AlanFord/CurrentSinkOrSwim/README.md

# CurrentSinkOrSwim
Building a current sink for battery testing in Contextual Electronics.

Here's the project so far:

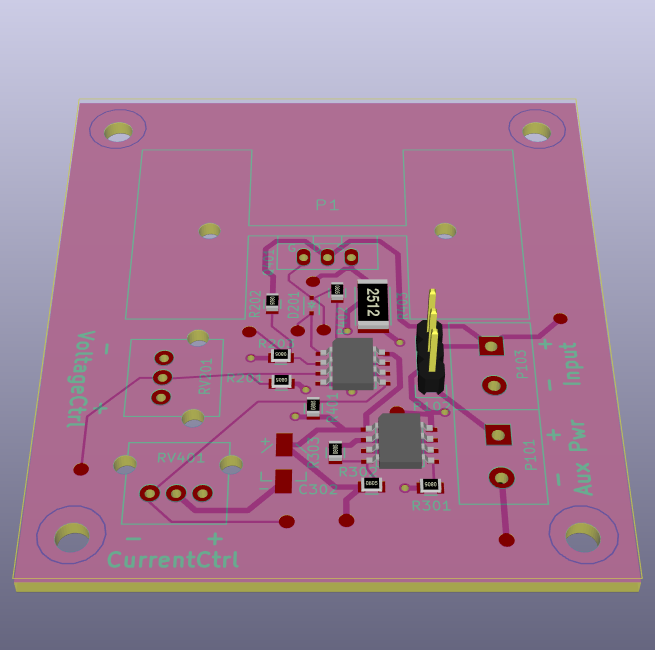
[picture p1: IMAGES/CurrentSinkOrSwim.png]


and

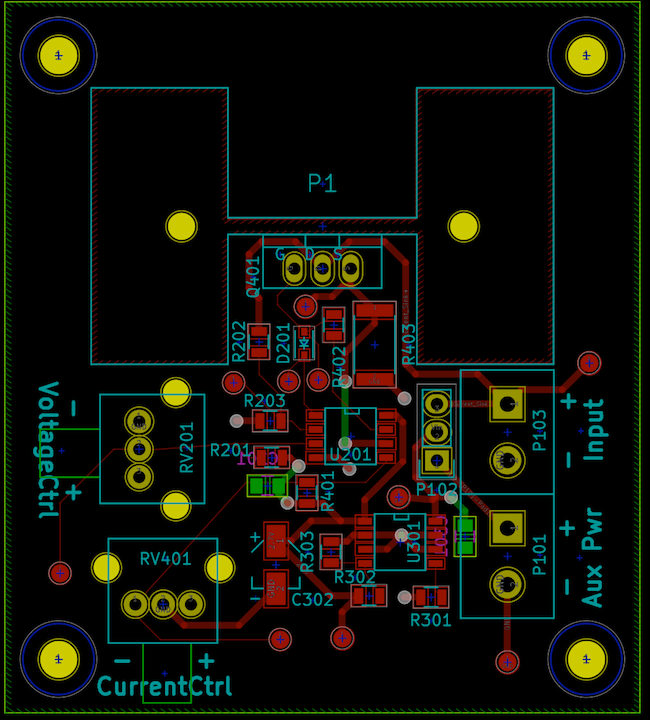
[picture p2: IMAGES/pcb.png]
