AlanFord/CurrentSinkOrSwim/CurrentSinkOrSwim.kicad_pcb

## KiCad design CurrentSinkOrSwim.kicad_pcb (2016-11-01)

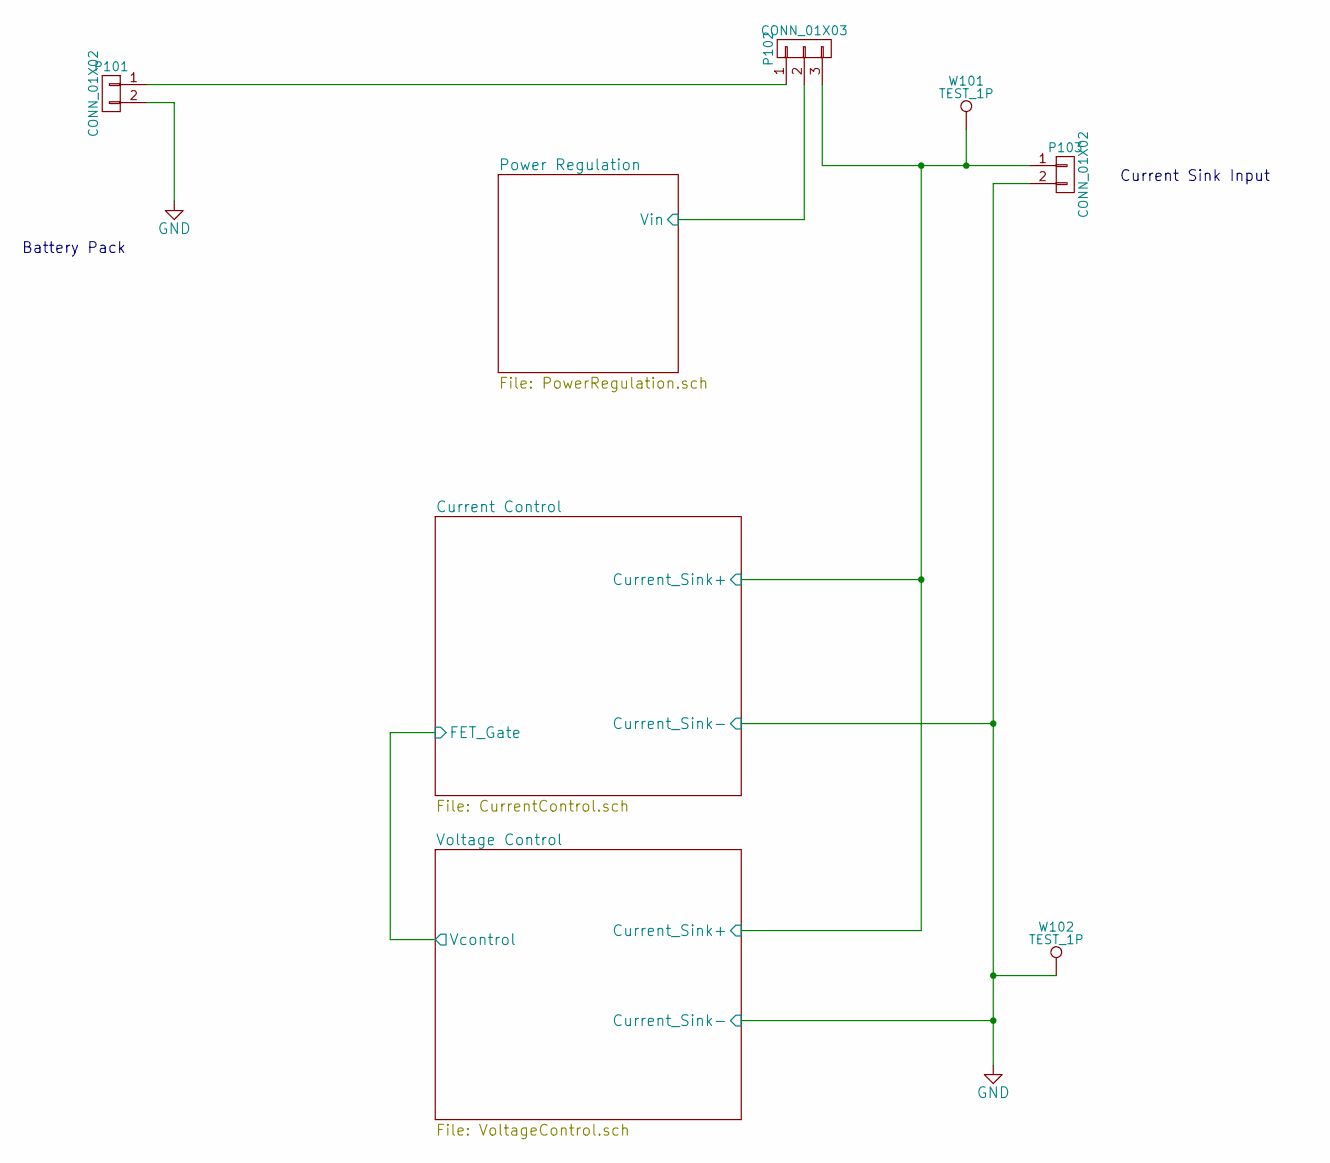
[picture p3: schematic CurrentSinkOrSwim.sch]

Parts:
P101, P103: CONN_01X02; Terminal_Block_200_mil; MPN OSTTC022162
P102: CONN_01X03; Pin_Header_Straight_1x03
W101, W102: TEST_1P; Measurement_Point_Round-SMD-Pad_Small

Connections:
/Current Control/Current_Sink+: P102.3, P103.1, W101.1; also elsewhere on the board
/Power Regulation/Vin: P102.2; also elsewhere on the board
GND: P101.2, P103.2, W102.1; also elsewhere on the board
unnamed: P101.1, P102.1

Notes on the sheet:
Battery Pack
Current Sink Input

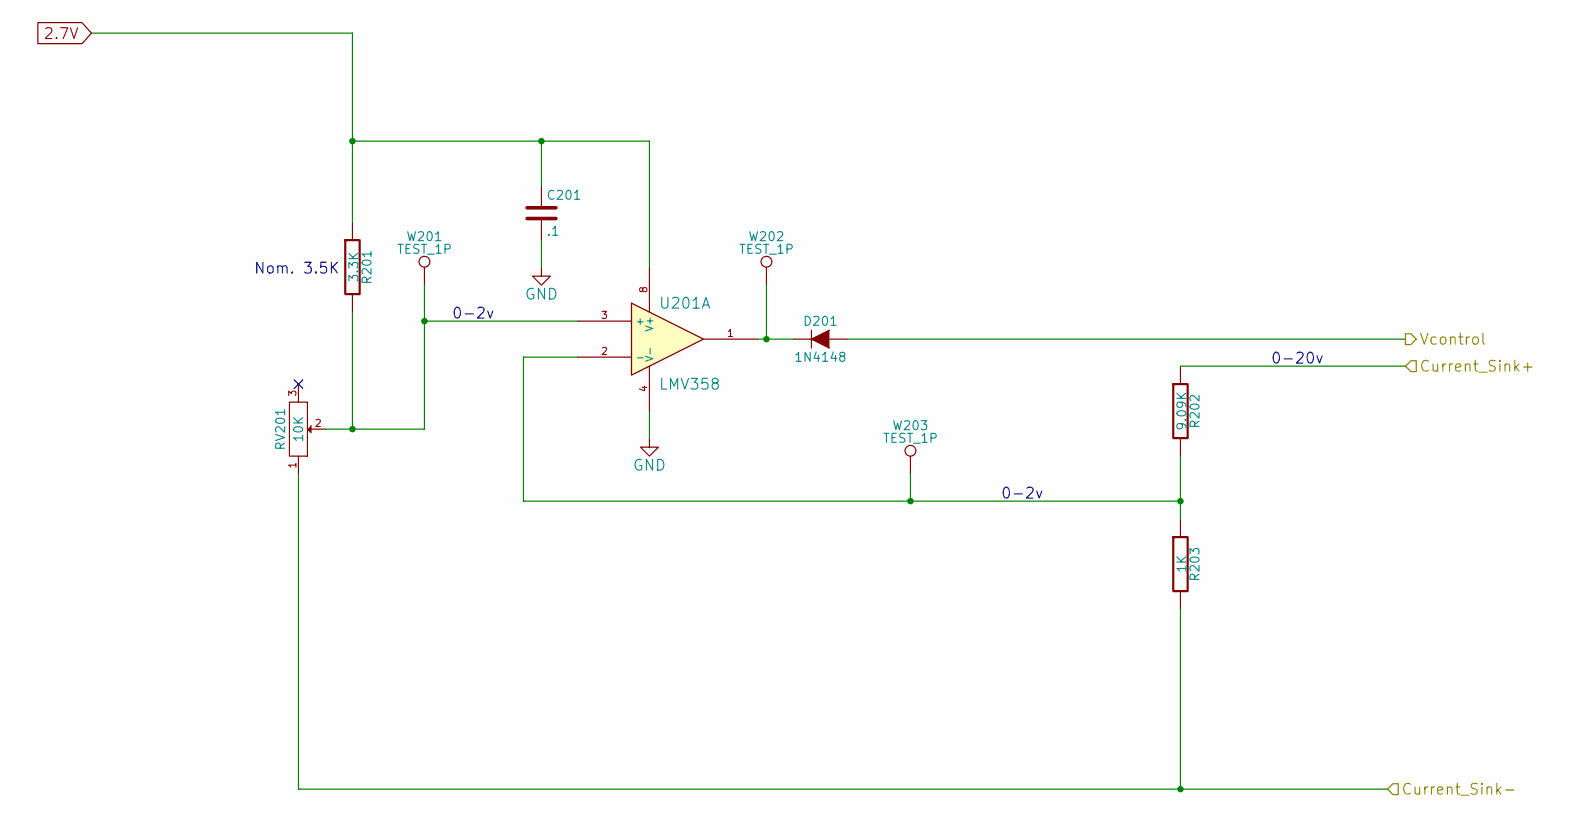
[picture p4: schematic VoltageControl.sch]

Parts:
C201: .1; C_0805
D201: 1N4148; SOD-323; MPN 1N4148WS-7-F
R201: 3.3K; R_0805
R202: 9.09K; R_0805
R203: 1K; R_0805
RV201: 10K; P090L-02F25BR10K; MPN P090L-02F25BR10K
U201: LMV358; SOIC-8-N; MPN LMV358IDT
W201, W202, W203: TEST_1P; Measurement_Point_Round-SMD-Pad_Small

Connections:
2.7V: C201.1, R201.1, U201.8 (V+); also elsewhere on the board
/Current Control/Current_Sink+: R202.1; also elsewhere on the board
/Current Control/FET_Gate: D201.2 (A); also elsewhere on the board
GND: C201.2, R203.2, RV201.1, U201.4 (V-); also elsewhere on the board
unnamed: D201.1 (K), U201.1, W202.1
unnamed: R201.2, RV201.2, U201.3 (+), W201.1
unnamed: R202.2, R203.1, U201.2 (-), W203.1

Notes on the sheet:
0-2v
0-20v
Nom. 3.5K

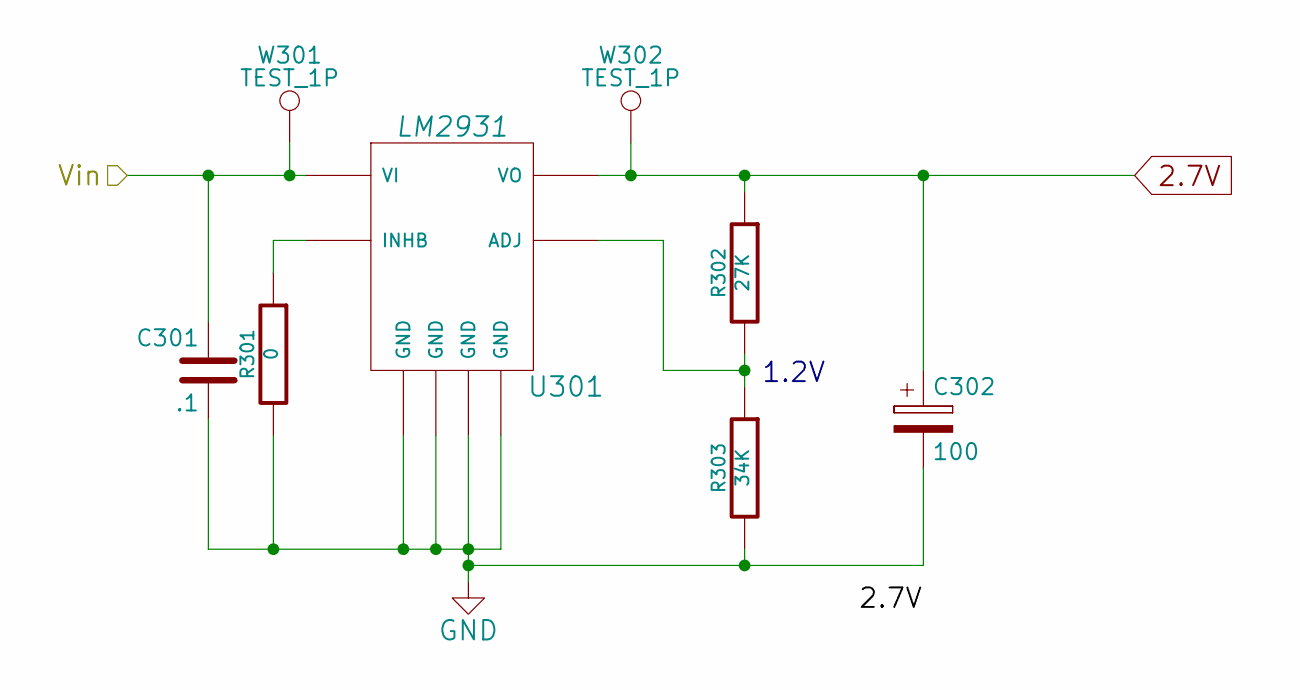
[picture p5: schematic PowerRegulation.sch]

Parts:
C301: .1; C_0805
C302: 100; PCE3867CT-ND; MPN PCE3867CT-ND
R301: 0; R_0805; MPN Value
R302: 27K; R_0805; MPN Value
R303: 34K; R_0805
U301: LM2931; SOIC-8-N; MPN LM2931D-R
W301, W302: TEST_1P; Measurement_Point_Round-SMD-Pad_Small

Connections:
2.7V: C302.1, R302.1, U301.1 (VO), W302.1; also elsewhere on the board
/Power Regulation/Vin: C301.1, U301.8 (VI), W301.1; also elsewhere on the board
GND: C301.2, C302.2, R301.2, R303.2, U301.2 (GND), U301.3 (GND), U301.6 (GND), U301.7 (GND); also elsewhere on the board
unnamed: R301.1, U301.5 (INHB)
unnamed: R302.2, R303.1, U301.4 (ADJ)

Notes on the sheet:
1.2V

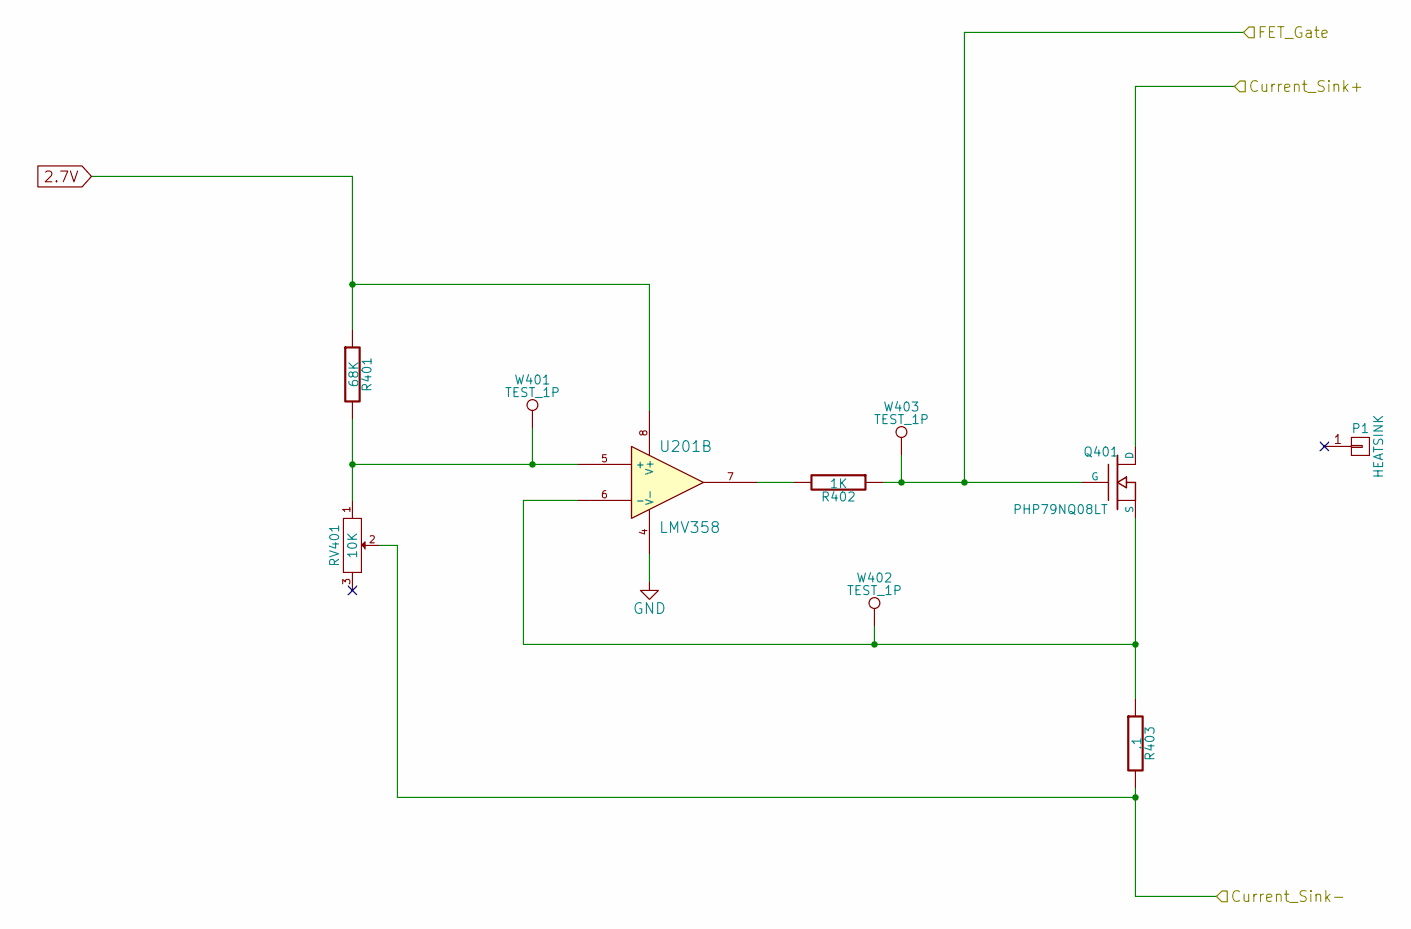
[picture p6: schematic CurrentControl.sch]

Parts:
P1: HEATSINK; FA-T220-38E; MPN FA-T220-38E
Q401: PHP79NQ08LT; TO-220_FET-GDS_Vertical; MPN PHP79NQ08LT,127
R401: 68K; R_0805
R402: 1K; R_0805
R403: .1; R_2512; MPN CRA2512-FZ-R100ELF
RV401: 10K; P090L-02F25BR10K; MPN P090L-02F25BR10K
U201: LMV358; SOIC-8-N
W401, W402, W403: TEST_1P; Measurement_Point_Round-SMD-Pad_Small

Connections:
2.7V: R401.1, U201.8 (V+); also elsewhere on the board
/Current Control/Current_Sink+: Q401.D; also elsewhere on the board
/Current Control/FET_Gate: Q401.G, R402.1, W403.1; also elsewhere on the board
GND: R403.2, RV401.2, U201.4 (V-); also elsewhere on the board
unnamed: Q401.S, R403.1, U201.6 (-), W402.1
unnamed: R401.2, RV401.1, U201.5 (+), W401.1
unnamed: R402.2, U201.7

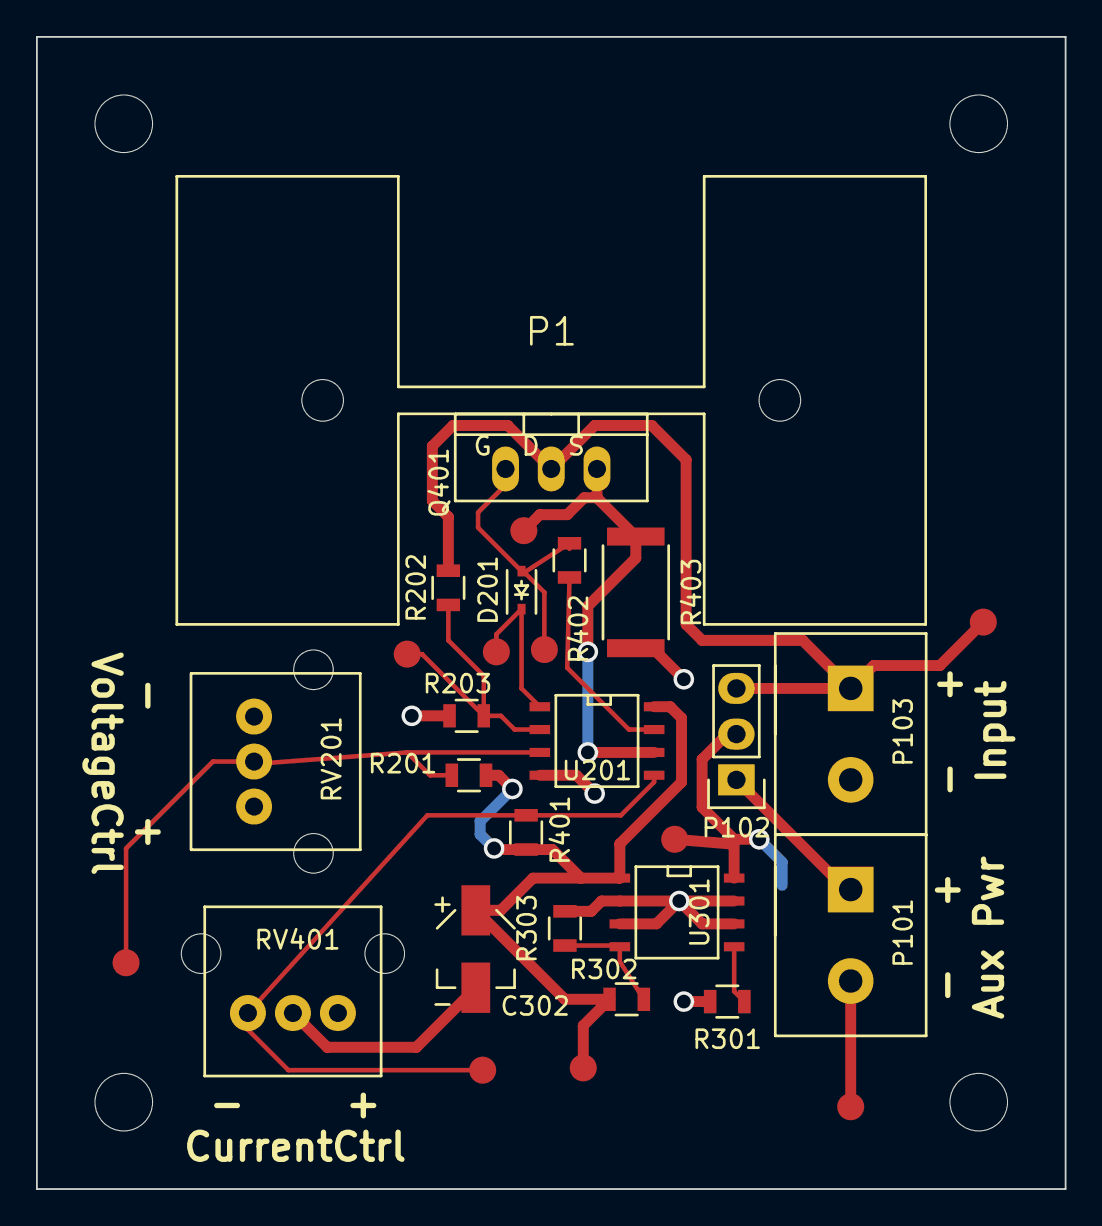
[picture p7: board CurrentSinkOrSwim.kicad_pcb from above]

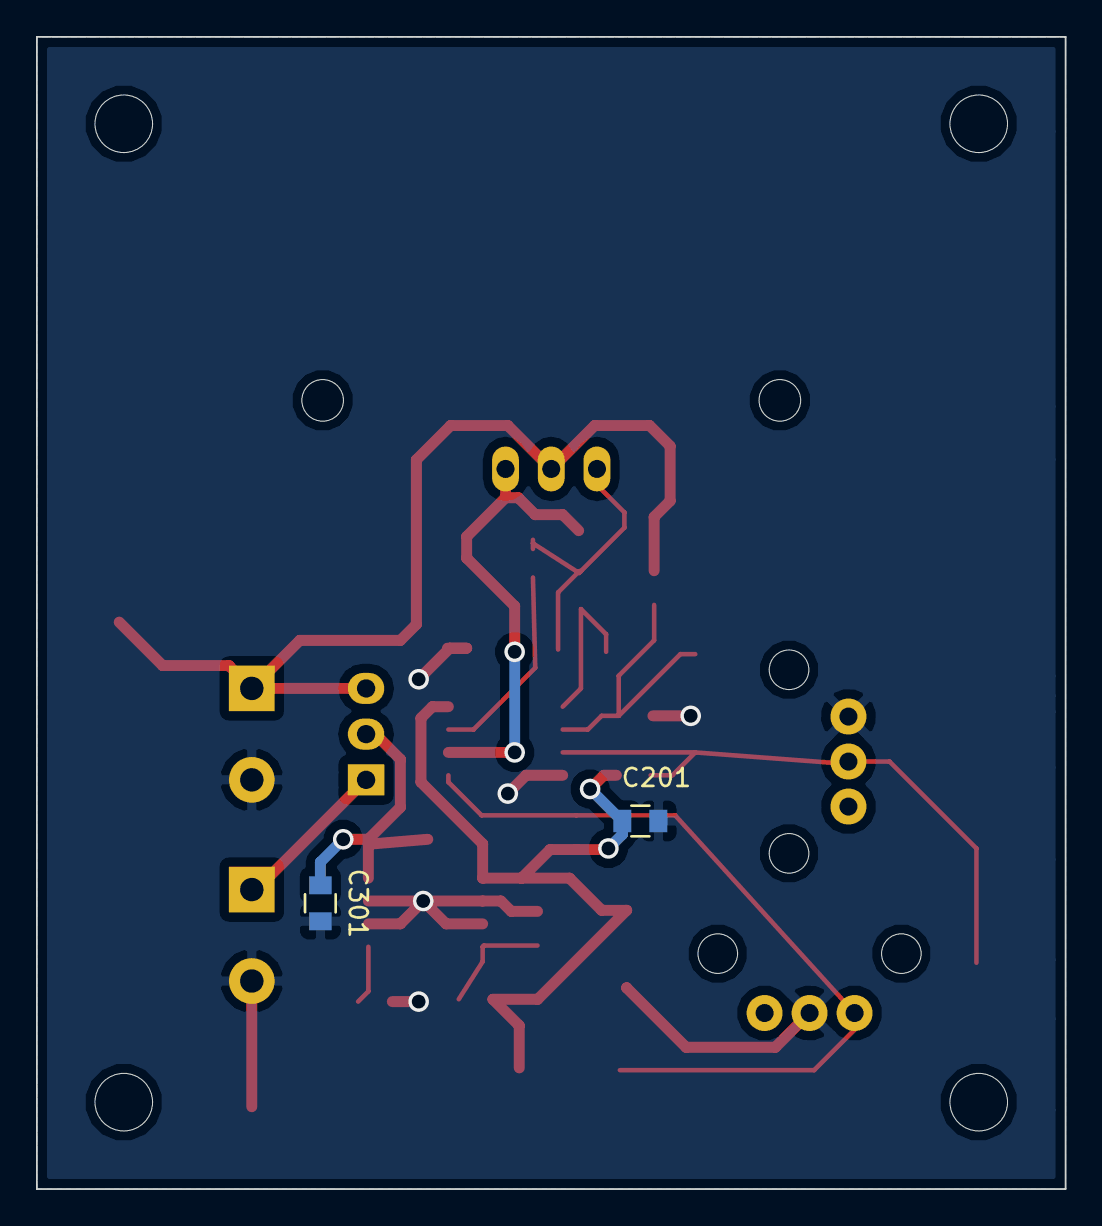
[picture p8: board CurrentSinkOrSwim.kicad_pcb from below]

Board: 2 copper layers, 57.1 x 64.0 mm, 32 parts (2 on the bottom side), 14 nets.
