AlanFord/CurrentSinkOrSwim/(commit log)

2016-08-14 updated project specific pcb library paths to use environment variables
2016-08-14 updated schematic capacitor symbols to use new default library symbols
    [CurrentControl.sch, CurrentSinkOrSwim.sch, PowerRegulation.sch, VoltageControl.sch]
2016-08-14 deleted orphaned libraries in EEschema, imported updated netlist into PCBNew and checked for errors
    [CurrentSinkOrSwim.kicad_pcb]
2016-08-16 corrected cap on voltage regulator and corrected voltage divider in voltage control
    [CurrentControl.sch, CurrentSinkOrSwim.sch, PowerRegulation.sch, VoltageControl.sch]
2016-08-22 updated diode to sod-323 package and used new schematic symbol because pin numbers changed
    [CurrentControl.sch, PowerRegulation.sch, VoltageControl.sch]
2016-08-22 added datasheet for 100uF cap
    [PowerRegulation.sch]
2016-08-22 added 100uF pcb footprint and misc comments
    [CurrentControl.sch, CurrentSinkOrSwim.kicad_pcb, PowerRegulation.sch, VoltageControl.sch]
2016-08-23 update pot footprints to have circular mounting holes
    [CurrentSinkOrSwim.kicad_pcb]
2016-08-24 initial component placement on the pcb
    [CurrentControl.sch, CurrentSinkOrSwim.kicad_pcb, PowerRegulation.sch, VoltageControl.sch]
2016-08-25 added keepout, ground plane, and moved caps to back side
    [CurrentSinkOrSwim.kicad_pcb]
2016-08-27 possible layout with over half of tracks
    [CurrentSinkOrSwim.kicad_pcb]
2016-08-29 added last ground traces, one backside trace, and vias to ground. passes drc.
    [CurrentSinkOrSwim.kicad_pcb]
2016-08-29 fixed edge cut
    [CurrentSinkOrSwim.kicad_pcb]
2016-08-30 updated sikscreen, shifted some components, enlarged ground plane, added mounting holes
    [CurrentSinkOrSwim.kicad_pcb]
2016-09-01 added labels, switched leads on voltage pot so + == clockwise, enlarged ground plane
    [CurrentSinkOrSwim.kicad_pcb, VoltageControl.sch]
2016-09-01 added test points to schematic and pcb
    [CurrentControl.sch, CurrentSinkOrSwim.kicad_pcb, CurrentSinkOrSwim.sch, PowerRegulation.sch, VoltageControl.sch]
2016-09-01 changed sense resistor to 2W, 2512SMD2
    [CurrentControl.sch, CurrentSinkOrSwim.kicad_pcb]
2016-09-02 added test point for GND
    [CurrentControl.sch, CurrentSinkOrSwim.kicad_pcb, CurrentSinkOrSwim.sch, PowerRegulation.sch, VoltageControl.sch]
2016-09-02 added notes for standoffs, jumper, and heat sink mounting
    [CurrentSinkOrSwim.sch]
2016-09-03 generated BOM
    [CurrentSinkOrSwim.csv]
2016-09-03 updated the gerbers
    [CurrentSinkOrSwim-B.Cu.gbl, CurrentSinkOrSwim-B.Mask.gbs, CurrentSinkOrSwim-B.SilkS.gbo, CurrentSinkOrSwim-B_Cu.gbl, CurrentSinkOrSwim-B_Mask.gbs, CurrentSinkOrSwim-B_SilkS.gbr, CurrentSinkOrSwim-Edge.Cuts.gm1, CurrentSinkOrSwim-Edge_Cuts.gko]
2016-09-04 revised resistors to match available values, replaced FET (old FET was obsolete/unavail)
    [CurrentControl.sch, CurrentSinkOrSwim.csv, CurrentSinkOrSwim.sch, PowerRegulation.sch, VoltageControl.sch]
2016-09-06 added png images of the board
2016-09-07 reduced size of pcb image to make it more suitable for web page use
2016-09-27 added fine-gain pot to the current control sheet
    [CurrentControl.sch]
2016-10-08 Revert "added fine-gain pot to the current control sheet"
    This reverts commit 2c8c25b55c9f8694f13c8f60d96001b4a7e97e34.
    After testing the Rev. 1, didn't need the fine gain potentiometer
    [CurrentControl.sch]
2016-11-01 adjusted R303 to get 2.7V, exchanged other parts for availability
    [CurrentSinkOrSwim.csv, CurrentSinkOrSwim.kicad_pcb, PowerRegulation.sch]
2016-11-15 added gerber file for solder stencil
    [CurrentSinkOrSwim-B.Cu.gbl, CurrentSinkOrSwim-B.Mask.gbs, CurrentSinkOrSwim-B.SilkS.gbo, CurrentSinkOrSwim-Edge.Cuts.gm1, CurrentSinkOrSwim-F.Cu.gtl, CurrentSinkOrSwim-F.Mask.gts, CurrentSinkOrSwim-F.Paste.gtp, CurrentSinkOrSwim-F.SilkS.gto]
